Johan-C777/coin-sorting-robot-pybullet/docs/img/banda-etapa2.png

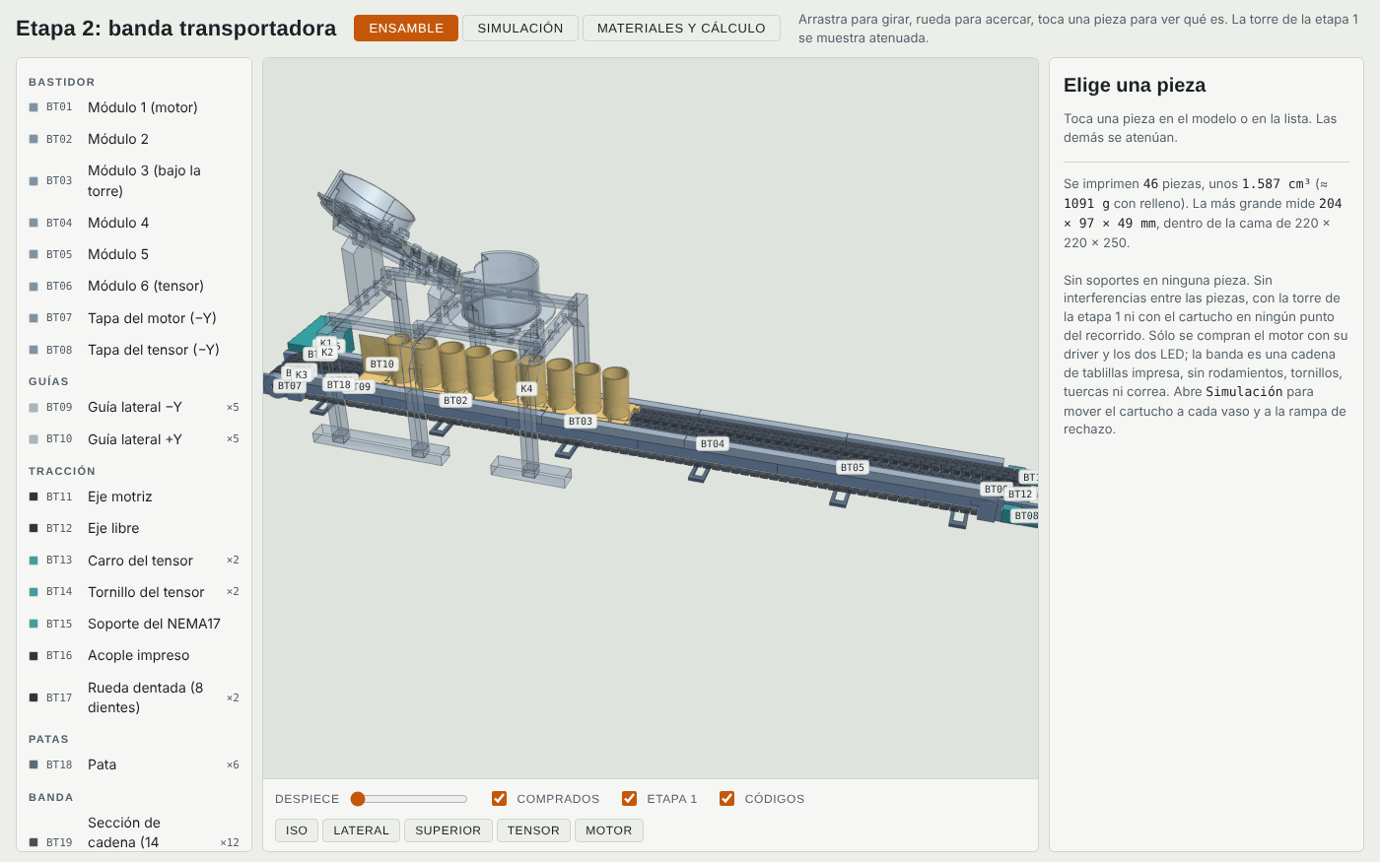
docs/img/banda-etapa2.png
