Johan-C777/coin-sorting-robot-pybullet/docs/img/memoria-portada.png

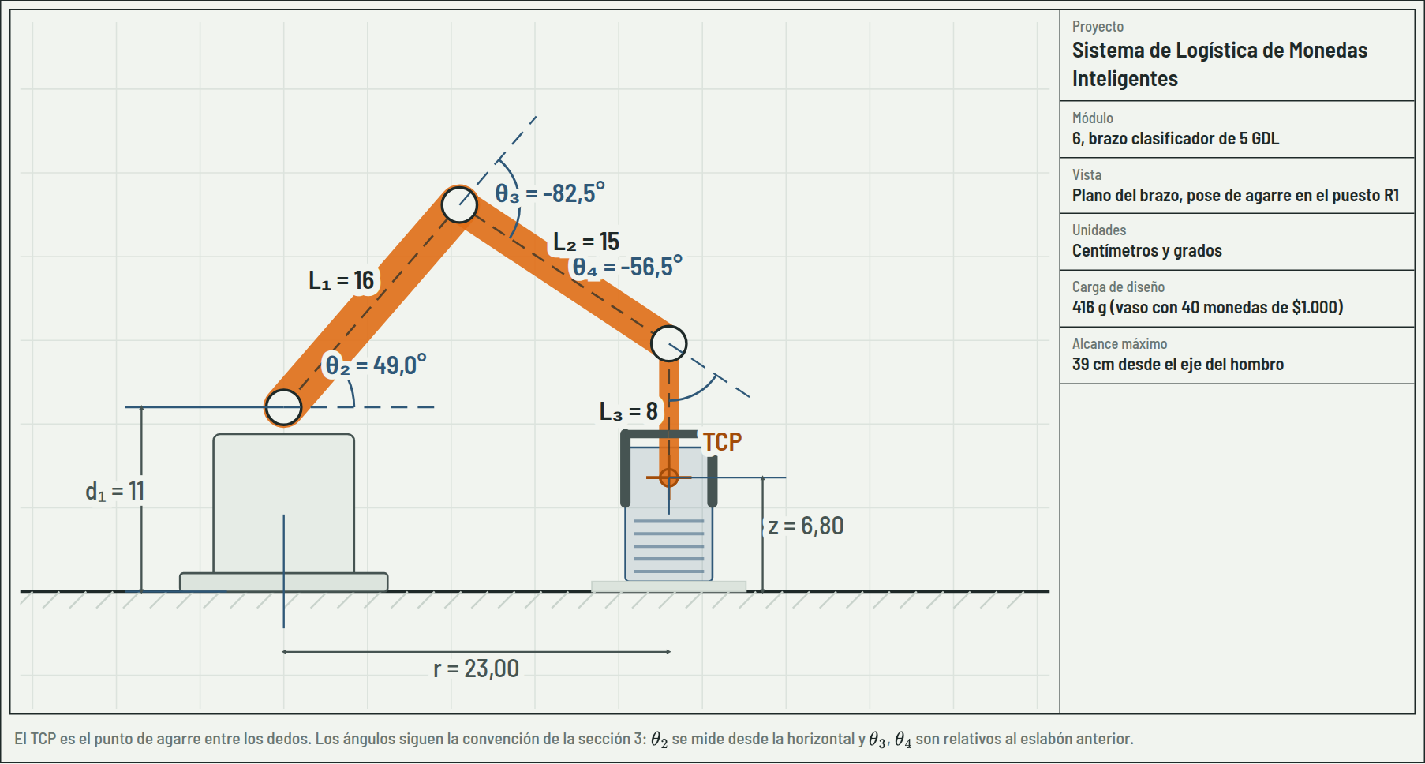
docs/img/memoria-portada.png
