Johan-C777/coin-sorting-robot-pybullet/hardware/etapa1-clasificador/ensamble_referencia.stl

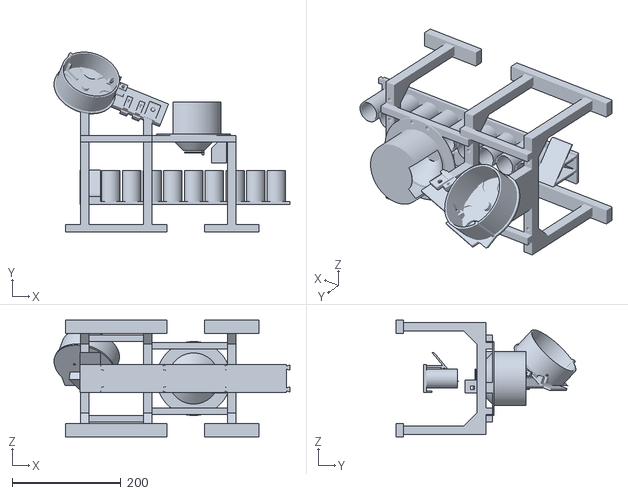
[picture p10: CAD file, 2026-10-27]
hardware/etapa1-clasificador/ensamble_referencia.stl
433.4 x 330.4 x 214.0
