Johan-C777/coin-sorting-robot-pybullet/hardware/archivo/etapa1-v3-canto/R00_probeta_ventanas.stl

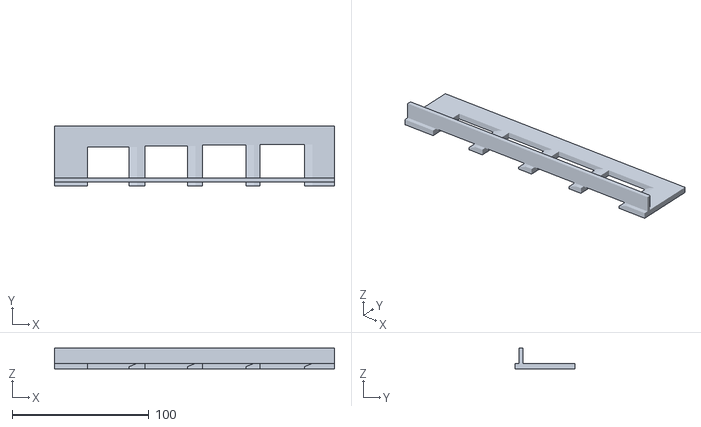
[picture p11: CAD file, 2026-10-27]
hardware/archivo/etapa1-v3-canto/R00_probeta_ventanas.stl
204.4 x 44.0 x 15.0
