Johan-C777/coin-sorting-robot-pybullet/hardware/archivo/etapa1-v4/stl/D5_adaptador_A100.stl

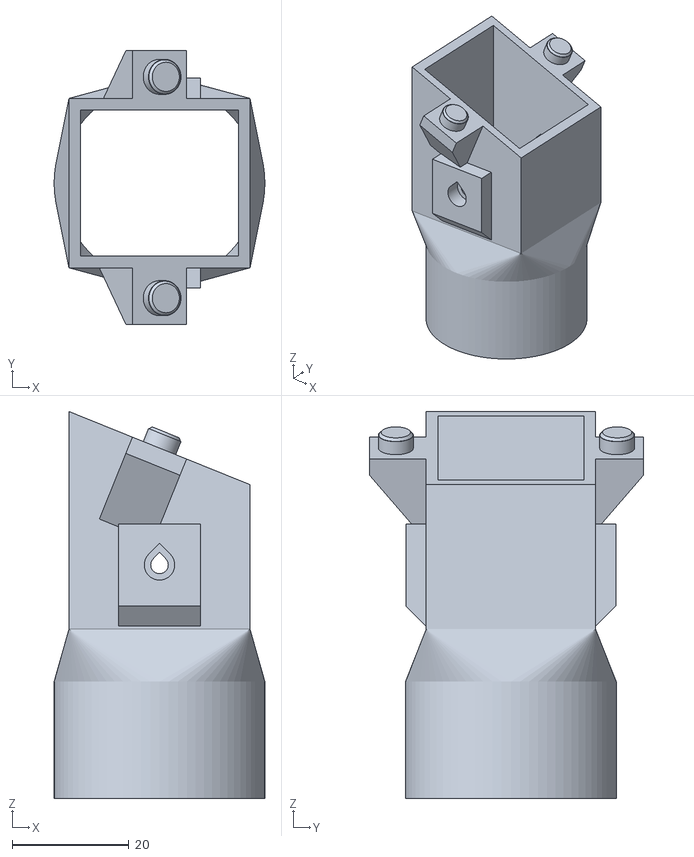
[picture p12: CAD file, 2026-10-27]
hardware/archivo/etapa1-v4/stl/D5_adaptador_A100.stl
36.1 x 46.9 x 66.3
