Johan-C777/coin-sorting-robot-pybullet/hardware/etapa1-clasificador/impresion/cama1_PLA+negro_prueba_tolva.3mf

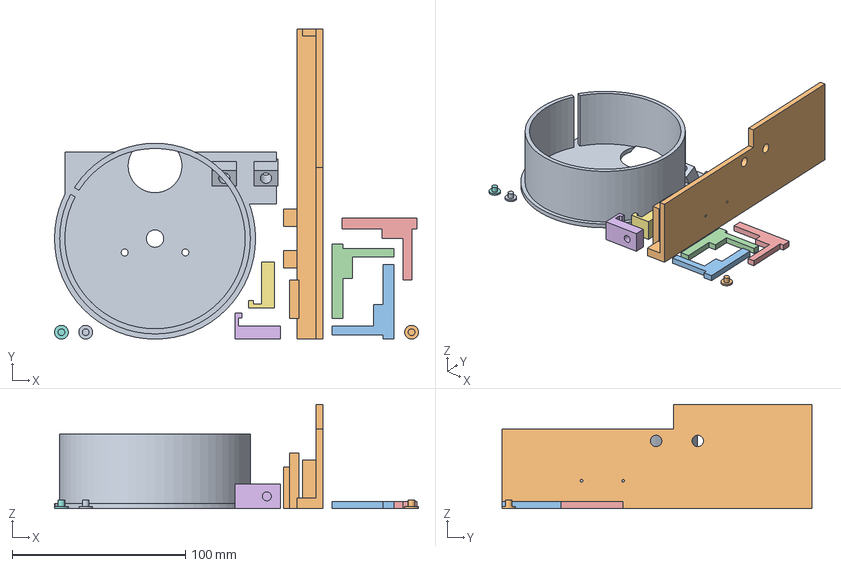
[picture p13: CAD file, 2026-10-27]
hardware/etapa1-clasificador/impresion/cama1_PLA+negro_prueba_tolva.3mf
210.0 x 179.0 x 60.0 mm
H01_base_tolva
L01_pista
H03a_rascador_2mm5
H03b_rascador_2mm6
H03c_rascador_2mm8
B01_porta_emisor_1
B01_porta_emisor_2
P03_remache_motor_1
P03_remache_motor_2
P03_remache_motor_3
