Johan-C777/coin-sorting-robot-pybullet/hardware/etapa1-clasificador/stl/ajustes/H03d_rascador_3mm0.stl

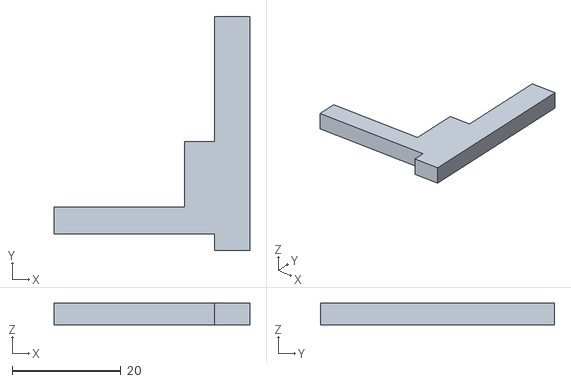
[picture p14: CAD file, 2026-11-03]
hardware/etapa1-clasificador/stl/ajustes/H03d_rascador_3mm0.stl
36.0 x 43.0 x 4.00
