Johan-C777/coin-sorting-robot-pybullet/hardware/etapa1-clasificador/stl/C02_rampa_rechazo.stl

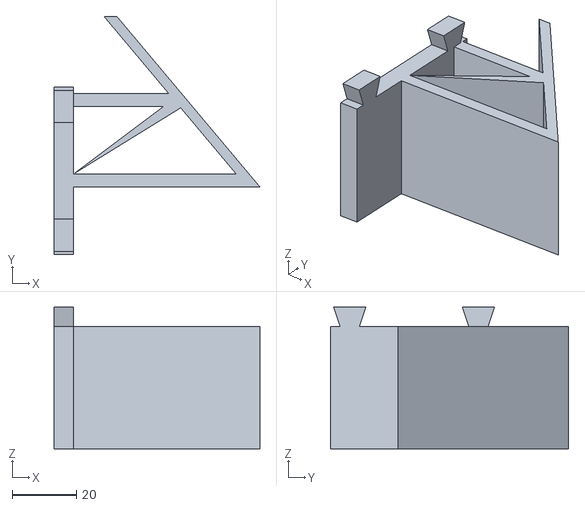
[picture p15: CAD file, 2026-10-27]
hardware/etapa1-clasificador/stl/C02_rampa_rechazo.stl
64.0 x 74.0 x 44.0
