Johan-C777/coin-sorting-robot-pybullet/hardware/Modelos3D/sistema_monedas_completo.3mf

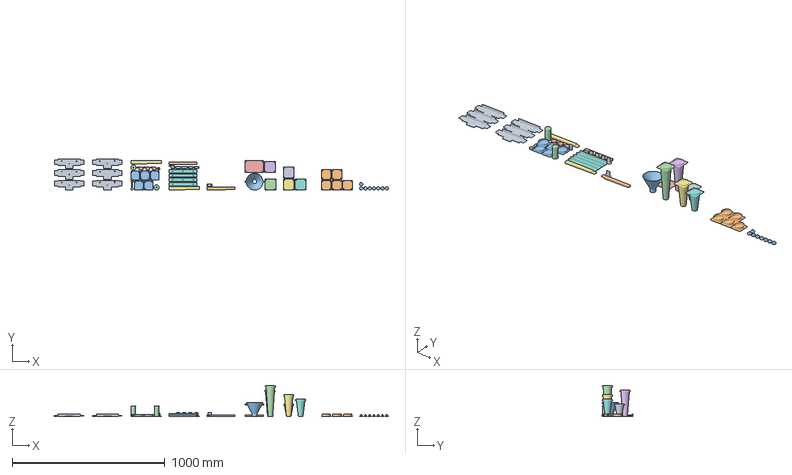
[picture p16: CAD file, 2026-10-05]
hardware/Modelos3D/sistema_monedas_completo.3mf
2190.0 x 204.0 x 205.7 mm
E10_marco_banda x 6
E06_paleta_dosificadora
E11_portavaso x 5
E09_rodillo_banda x 2
E04_abrazadera_varilla x 4
E12_acople_motor
E01_riel_tramo_a x 2
E03_canal_costado x 4
E08_soporte_sensor x 5
E02_riel_tramo_b x 2
E05_tolva
E07_embudo_estacion1
B12_bandeja_electronica
E07_embudo_estacion2
E07_embudo_estacion3
E07_embudo_estacion4
E07_embudo_estacion5
B11_puesto_rack x 5
E13_pie_nivelador x 8
