Johan-C777/coin-sorting-robot-pybullet/hardware/Modelos3D/stl/E11_portavaso.stl

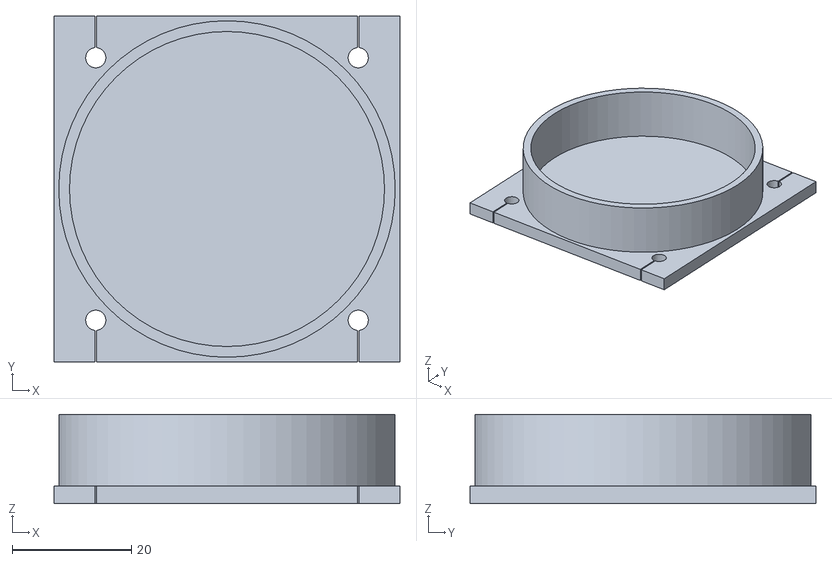
[picture p17: CAD file, 2026-10-05]
hardware/Modelos3D/stl/E11_portavaso.stl
58.0 x 58.0 x 15.0
