Johan-C777/coin-sorting-robot-pybullet/hardware/archivo/etapa1-v4/stl/B03_puente_sensor.stl

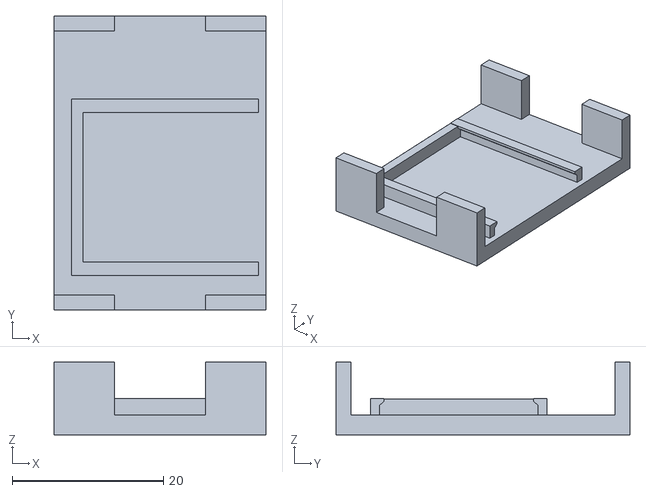
[picture p18: CAD file, 2026-10-27]
hardware/archivo/etapa1-v4/stl/B03_puente_sensor.stl
28.0 x 38.9 x 9.60
