Johan-C777/coin-sorting-robot-pybullet/hardware/etapa1-clasificador/impresion/cama3_PLA+negro_embudo_cartucho_prueba.3mf

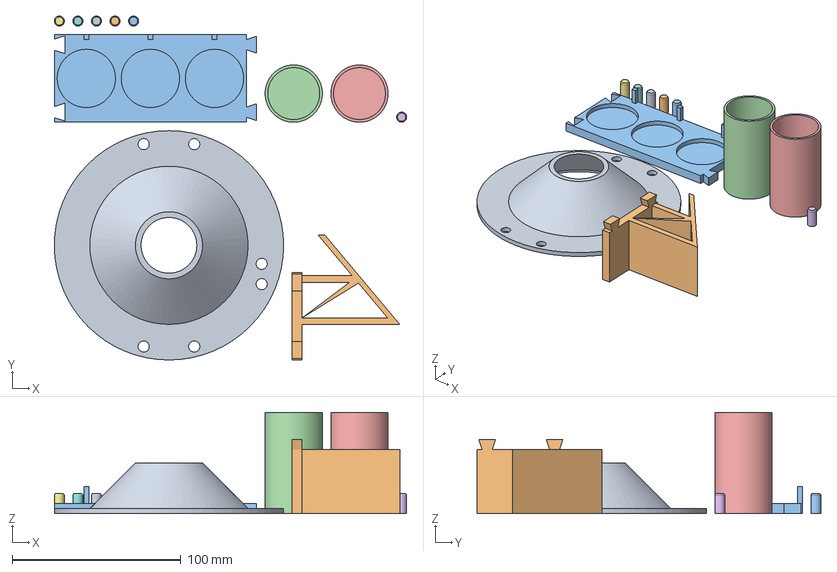
[picture p19: CAD file, 2026-10-27]
hardware/etapa1-clasificador/impresion/cama3_PLA+negro_embudo_cartucho_prueba.3mf
209.0 x 204.0 x 60.0 mm
F01_embudo_1
C02_rampa_rechazo_1
C01_cartucho_1
V01_vaso_1
V01_vaso_2
P02_clavija_12mm_1
P02_clavija_12mm_2
P02_clavija_12mm_3
P02_clavija_12mm_4
P02_clavija_12mm_5
P02_clavija_12mm_6
