Johan-C777/coin-sorting-robot-pybullet/hardware/Modelos3D/stl/E01_riel_tramo_a.stl

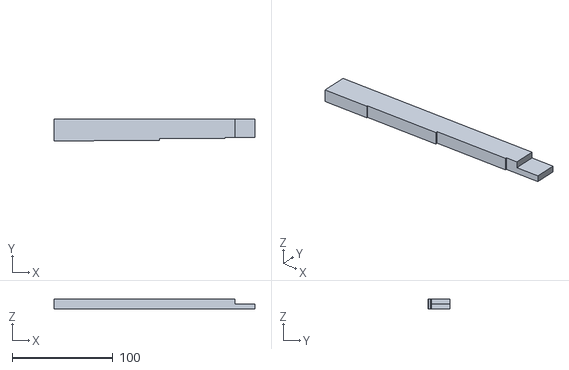
[picture p20: CAD file, 2026-10-05]
hardware/Modelos3D/stl/E01_riel_tramo_a.stl
200.0 x 22.0 x 10.0
