Johan-C777/coin-sorting-robot-pybullet/hardware/etapa1-clasificador/stl/R03_pata1_izq.stl

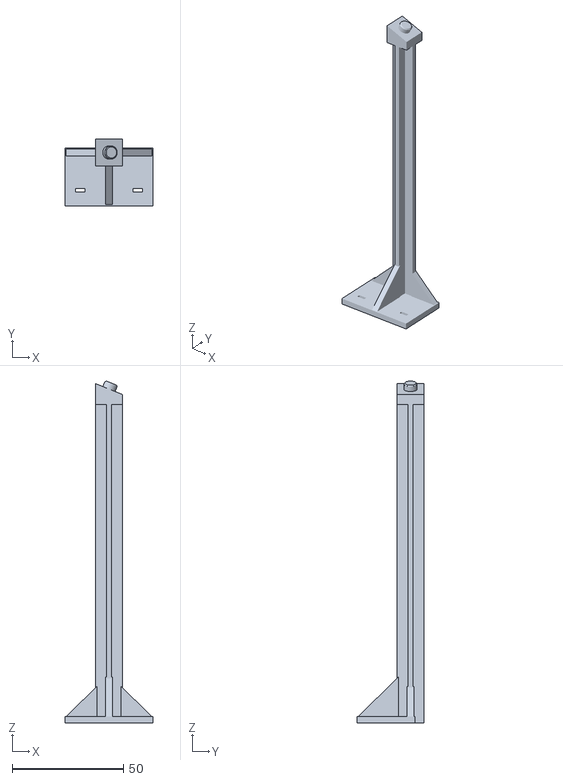
[picture p21: CAD file, 2026-10-20]
hardware/etapa1-clasificador/stl/R03_pata1_izq.stl
39.5 x 30.0 x 153.8
