Johan-C777/coin-sorting-robot-pybullet/hardware/Modelos3D/stl/B12_bandeja_electronica.stl

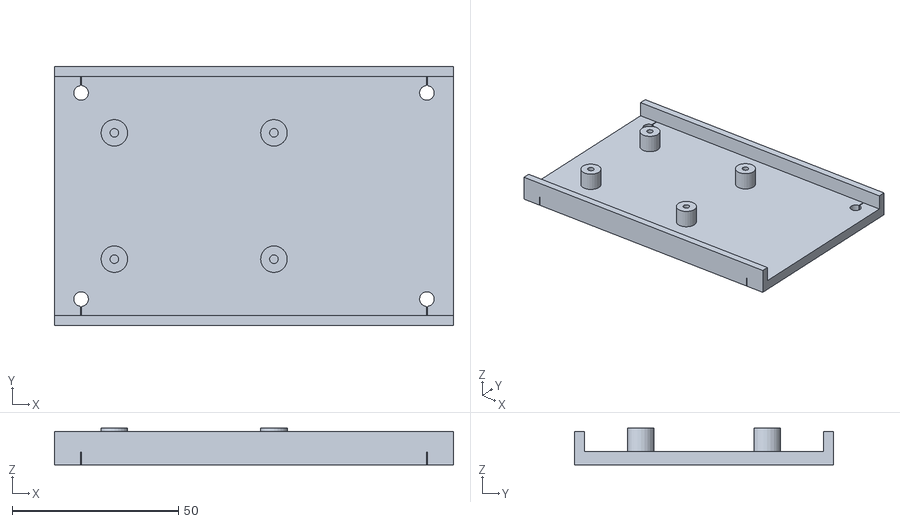
[picture p22: CAD file, 2026-10-05]
hardware/Modelos3D/stl/B12_bandeja_electronica.stl
120.0 x 78.0 x 11.0
