Johan-C777/coin-sorting-robot-pybullet/hardware/etapa1-clasificador/stl/D8_adaptador_N1000.stl

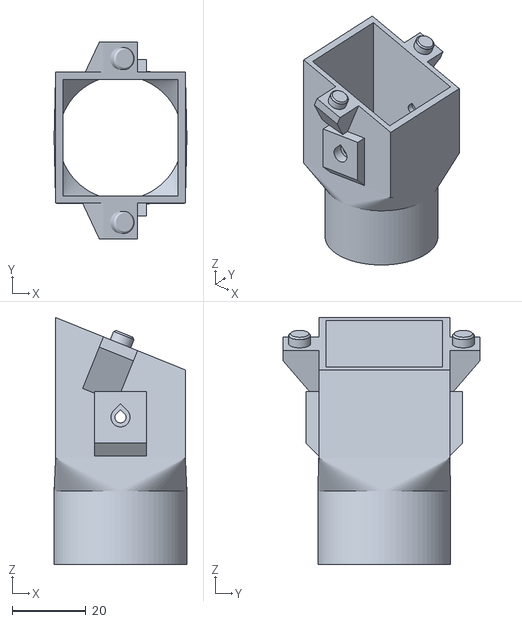
[picture p23: CAD file, 2026-10-20]
hardware/etapa1-clasificador/stl/D8_adaptador_N1000.stl
36.1 x 53.5 x 67.1
