Johan-C777/coin-sorting-robot-pybullet/hardware/Modelos3D/stl/E03_canal_costado.stl

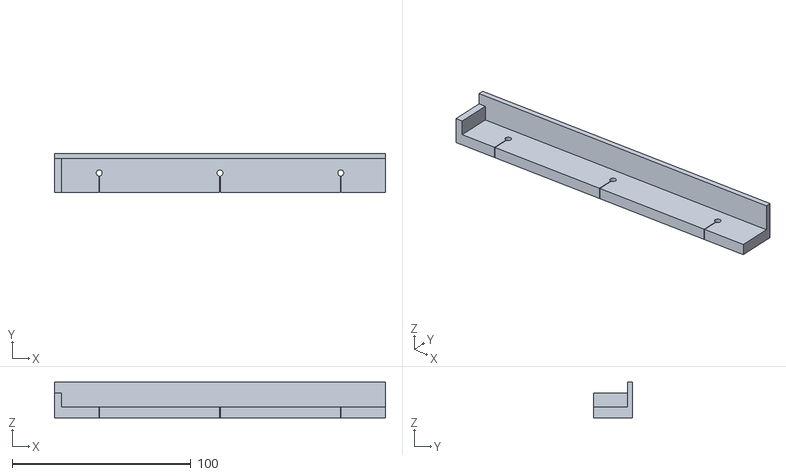
[picture p24: CAD file, 2026-10-05]
hardware/Modelos3D/stl/E03_canal_costado.stl
185.0 x 22.0 x 20.0
