Johan-C777/coin-sorting-robot-pybullet/hardware/etapa1-clasificador/stl/B02_plato_desvio.stl

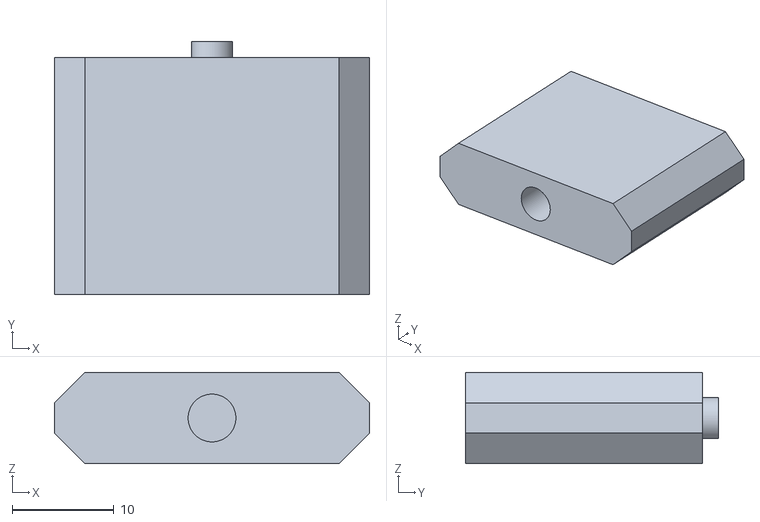
[picture p25: CAD file, 2026-10-20]
hardware/etapa1-clasificador/stl/B02_plato_desvio.stl
31.0 x 24.9 x 9.00
