Johan-C777/coin-sorting-robot-pybullet/hardware/Modelos3D/stl/E04_abrazadera_varilla.stl

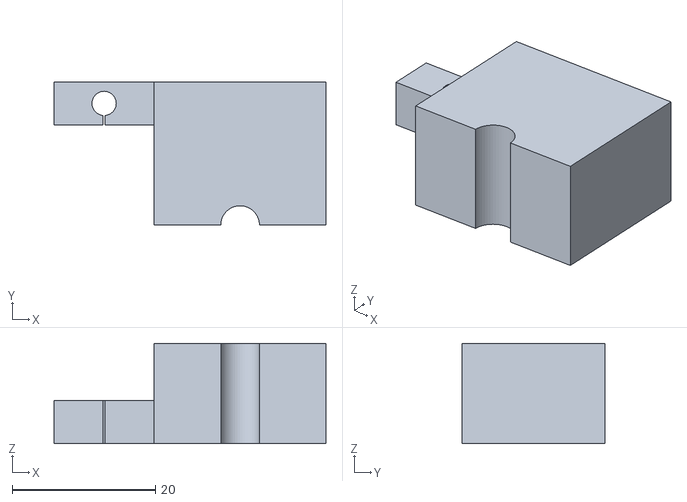
[picture p26: CAD file, 2026-10-05]
hardware/Modelos3D/stl/E04_abrazadera_varilla.stl
38.0 x 20.0 x 14.0
