Johan-C777/coin-sorting-robot-pybullet/hardware/etapa1-clasificador/stl/R01_riel_modulo_A.stl

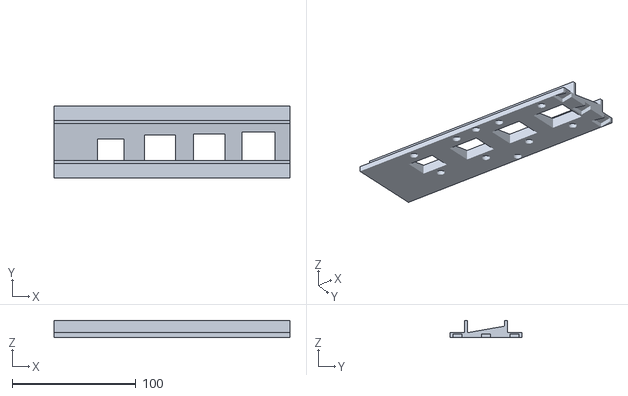
[picture p27: CAD file, 2026-10-20]
hardware/etapa1-clasificador/stl/R01_riel_modulo_A.stl
190.5 x 58.0 x 14.0
