Johan-C777/coin-sorting-robot-pybullet/hardware/Modelos3D/stl/E06_paleta_dosificadora.stl

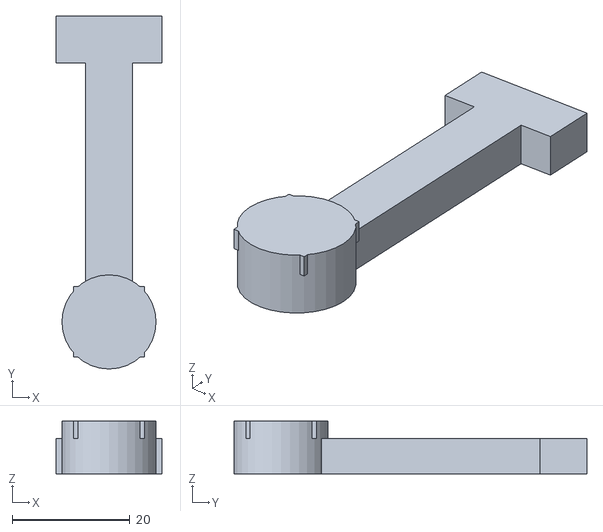
[picture p28: CAD file, 2026-10-05]
hardware/Modelos3D/stl/E06_paleta_dosificadora.stl
18.0 x 60.0 x 9.00
