Johan-C777/coin-sorting-robot-pybullet/hardware/etapa1-clasificador/stl/R03_pata3_der.stl

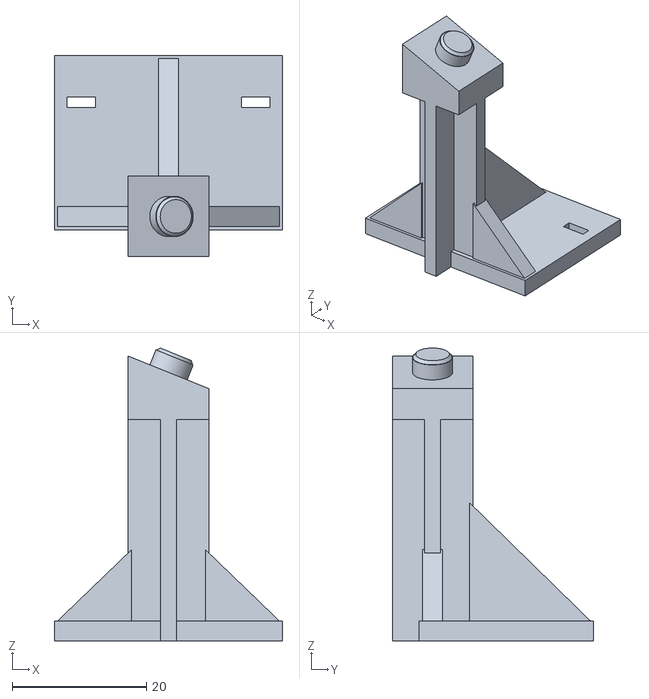
[picture p29: CAD file, 2026-10-20]
hardware/etapa1-clasificador/stl/R03_pata3_der.stl
34.0 x 30.0 x 43.6
