Johan-C777/coin-sorting-robot-pybullet/hardware/Modelos3D/stl/E07_embudo_estacion4.stl

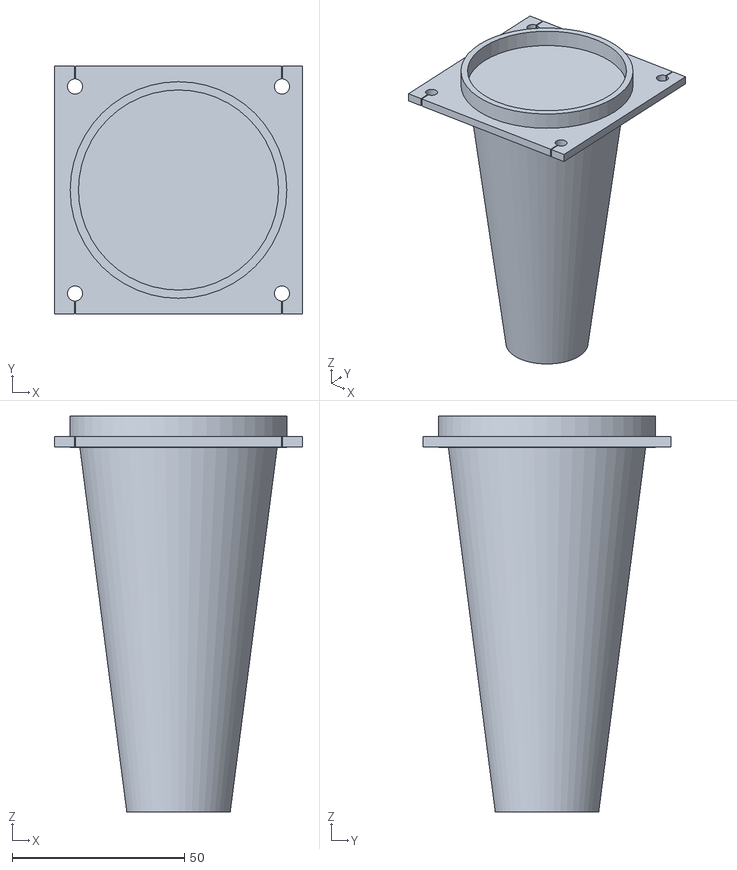
[picture p30: CAD file, 2026-10-05]
hardware/Modelos3D/stl/E07_embudo_estacion4.stl
72.0 x 72.0 x 114.8
