Johan-C777/coin-sorting-robot-pybullet/hardware/Modelos3D/stl/E07_embudo_estacion1.stl

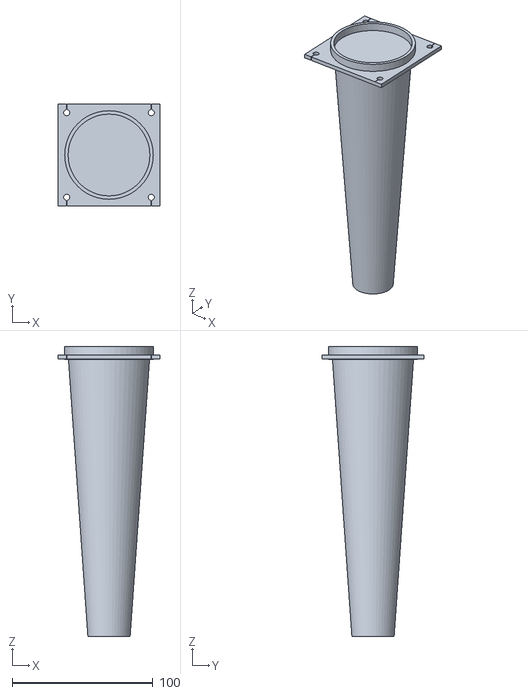
[picture p32: CAD file, 2026-10-05]
hardware/Modelos3D/stl/E07_embudo_estacion1.stl
72.0 x 72.0 x 205.7
