Johan-C777/coin-sorting-robot-pybullet/hardware/Modelos3D/stl/E10_marco_banda.stl

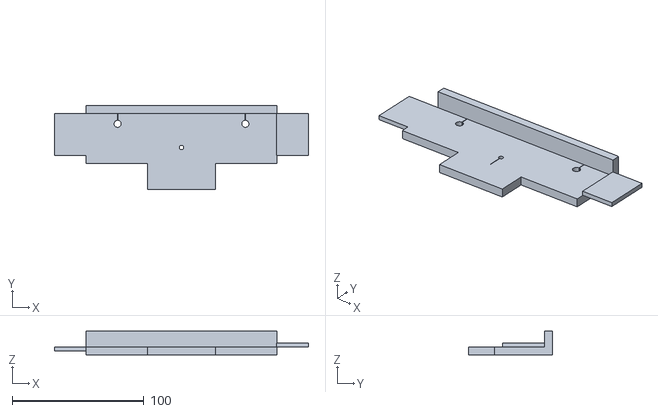
[picture p33: CAD file, 2026-10-05]
hardware/Modelos3D/stl/E10_marco_banda.stl
193.0 x 64.0 x 18.0
