Johan-C777/coin-sorting-robot-pybullet/(list of files, cad)

Other CAD files:
hardware/etapa1-clasificador/stl/H03c_rascador_2mm8.stl
hardware/archivo/etapa1-v1/stl/E08_soporte_sensor.stl
hardware/archivo/etapa1-v1/stl/E12_acople_motor.stl
