Johan-C777/coin-sorting-robot-pybullet/docs/pruebas/etapa1/img/error_puerta.jpg

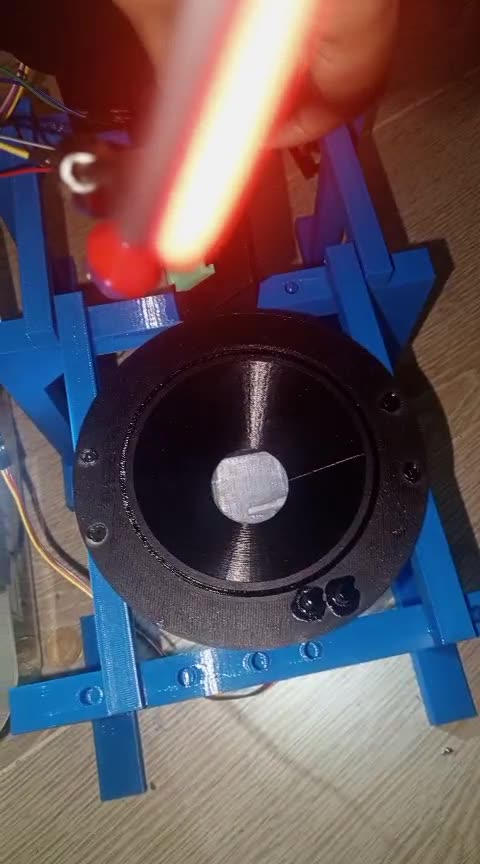
docs/pruebas/etapa1/img/error_puerta.jpg
