Johan-C777/coin-sorting-robot-pybullet/(commit log)

2026-10-13 Entrega de avances: monedas antiguas y nuevas, ruta A-B por niveles y CI
    - Selector de 8 estaciones para monedas de las dos familias del Banco de la
    República (software/brazo/monedas.py), con STL, 3MF y firmware al día.
    - Conteo por estación y por familia en el contador; el brazo lee, pesa y
    ordena por monedas antiguas.
    - Cuatro obstáculos con nivel de dificultad entre el punto A y el punto B;
    planificador en Python verificado contra la simulación web.
    - Simulaciones web con el riel nuevo, tubos colectores y rótulos A/B.
    - Corrige POST /api/pose (no movía los servos) y el comando ENVIAR del
    contador, que no existía.
    - README reescrito, documento de entrega, docs de monedas y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
2026-10-14 Clasificador físico FDM: tolva, riel modular, bifurcación de $500 e IR en 9 ductos
    Script paramétrico scripts/generar_clasificador.py (manifold3d) con STL en hardware/stl/, firmware del contador con 9 interrupciones IR, TCS34725 por I2C, aguja SG90 y tolva 28BYJ-48 a 1 moneda/1,5 s.
2026-10-14 Clasificador: piezas mas livianas y orientacion automatica sin voladizos
    Ductos rectos de pared fina, riel y cunas aligerados, bifurcacion de perfil delgado, analizador de voladizos y chequeo de interferencias.
2026-10-19 Visor 3D del ensamble de la etapa 1
2026-10-19 Etapa 1 sin tornillos ni soportes, bifurcador de $500 alineado con los vasos y visor con simulación
2026-10-19 Base de listones y tablero para sostener riel y tolva; nueve vasos, uno por tipo de moneda
2026-10-19 Ductos hasta los vasos sin mangueras, base de lámina sobre patas de PVC con codos impresos
2026-10-19 Ductos y base en PVC: adaptadores impresos + tubo de 1", base ABS de extremo, tees de 3/4"
2026-10-19 Visor y tabla de piezas con lámina de 9 mm
2026-10-19 Guía de armado de la etapa 1 y ajuste de agujeros de la lámina
2026-10-19 Prueba del riel: compara los 9 ductos del firmware con las 8 estaciones del modelo
2026-10-20 Repositorio por etapas y avance consolidado (0.5.0)
    hardware/ dividido en etapa1-clasificador, etapa2-transporte, etapa3-brazo y
    archivo; visor 3D en docs/ para GitHub Pages; docs renumerados; BOM de la
    etapa 1 según la guía; README, entrega de avances, CHANGELOG y ESTADO al día.
2026-10-20 Guía: cruce con el inventario (resistencias de 330 ohm, condensador de 220 uF, lista de faltantes)
2026-10-20 BOM de la etapa 1 con el inventario: 330 ohm y 220 uF
2026-10-20 0.5.1 y 0.6.0: monedas oficiales y nueve vasos al brazo (#4)
    * Riel: ranura 3 a 22,0 mm (la $50 antigua mide 21,5), ranura 4 a 22,8, $500 antigua oficial; prueba del generador
    * CHANGELOG 0.5.1
    * Contador: nueve vasos, uno por ducto; trama y JSON con familia
    * Brazo: 9 puestos por zona, vasos de 34 mm, obstaculos reajustados (Python y simulador web)
    * Firmware del brazo: 9 puestos, pinza 31 mm, vaso 34 mm
    * Docs, PyBullet y estado: nueve vasos al brazo (0.6.0)
    ---------
2026-10-22 Cuña de calibración del riel: ventana que se ensancha para medir dónde cae cada moneda
2026-10-23 Rediseño v3: riel de monedas de canto, probeta de ventanas y simulaciones MuJoCo
2026-10-23 Agregar simulación MuJoCo de rodadura por gravedad (pista inclinada, barreras, aleta y tope)
2026-10-23 Agregar simulaciones de embudo y compuerta; ESTADO con el rediseño v4
2026-10-23 ESTADO: rediseño v5 compacto de pie sobre la banda
2026-10-23 Etapa 1 v5: tolva de disco inclinado, embudo compacto, compuerta y cartucho; STL, despiece y guía de armado
2026-10-23 Camas de impresion v5 en 3MF con material por cama
2026-10-24 H01 y L01 sin soportes: espalda plana con remaches, pista de pie; K01 y G02 reorientadas
2026-10-27 Etapa 1 v5 ordenada: piezas, camas, despiece y electrónica ESP32-S3 (0.7.0)
    - hardware/etapa1-clasificador pasa a la torre de canto v5 (stl, impresion, despiece, compras)
    - v4 y probetas v3 al archivo; generadores con las rutas nuevas
    - docs 09-clasificador-v5 y 11-electronica-etapa1 con esquema de cableado
    - firmware/etapa1_prueba_motor (PlatformIO, ESP32-S3)
    - README, portada, entrega de avances, CHANGELOG y ESTADO
2026-11-01 Módulo clasificador de monedas: firmware PlatformIO, documentación maestra y sitio de demos (0.8.0) (#7)
    Firmware de operación firmware/etapa1_clasificador (ESP32-S3): medición por cuerda con aceleración constante, tolerancia por clase, color para las $500, máquina de estados de 11 estados, ISR de barreras, PCNT del TCS3200 y calibración [CAL-01..12]; 16 pruebas Unity y compilación en CI. README maestro, TODO.md, esquema de conexiones, CHANGELOG 0.8.0 y visores 3D del clasificador v5 y de la banda en GitHub Pages.
2026-11-01 Etapa 1: impresión completa en toda la documentación (0.8.1) (#8)
    Todas las camas de la torre v5 están impresas; TODO.md, README, portada, docs, hardware/ y ESTADO lo reflejan. La fase 4 queda como procedimiento de montaje y calibración; la BOM y compras.md pasan a lista de componentes.
2026-11-01 Visor 3D: quita meta de vista no estándar
2026-11-03 Etapa 1: primera ronda de pruebas físicas (0.9.0) (#10)
    Registro con 13 evidencias (videos y fotos) y 6 hallazgos con su corrección: rampa trasera, disco de 6 bolsillos, fricción del disco, segunda paleta de la compuerta, monedas verticales en la tolva llena y jumpers cortos.
2026-11-03 Ajusta la redacción del mapa del repositorio y de ESTADO (#12)
2026-11-03 Etapa 1: disco de 6 bolsillos, firmware de banco continuo y guía de montaje (#13)
    Disco H02c de 6 bolsillos Ø33, BOLSILLOS = 6 en los dos firmwares, banco con giro continuo, platformio.ini con pioarduino y guía de montaje y pruebas.
2026-11-03 Etapa 1: tope trasero H04 y rascador H03d (#14)
    Bloque H04 de 40 x 14 x 14 mm que rellena la cuña entre L01 y el aro de H01, y rascador H03d de 3,0 mm para la moneda de $1.000.
2026-11-03 Entrega de avances de las etapas 1 y 2 (0.10.0) (#15)
    README con equipo, etapa 2 en rediseño y etapa 3; disco de 6 bolsillos en la documentación; Pages con versiones vigentes y proceso de diseño aparte.
2026-11-03 H04 como rectángulo simple, paleta plana G03 y retirada de H03d
2026-11-03 H02c con la cara trasera plana como el H02 anterior
